JulCesarCorrea/Basic-EPS/Docs/Componentes_EPS.xlsx

Part | Manufacturer | Quantity | Price ($) | Footprint (mm²) | Description | LCSC PART | Reserva | Notas | Mass (mg) | Type
TPS54560DDAR | TI | 1 | $ 1,11 | 4x6mm | Buck | C31966 |  | Temperatura |  | Extend
RS1040-6R8MS | Ruishen | 1 | $ 0.142 | 11x10mm | Indutor | C32712978 |  | Poucos em estoque |  | Extend
B560C-13-F | DIODES | 1 | $ 0.19 | 6x7mm | Diodo | 85100 |  | Temperatura |  | Extend
TMK325B7226KMHP | Taiyo Yuden | 2 | $ 0.34 | 2x3mm | capatior 22uF | C386098 |  | 1210 X7R |  | Extend
FN18X104K250PSG | PSA | 2 | $ 0.01 | 1x1,5mm | capator 100nF | C235730 |  | 0603 - X7R |  | Extend
0603WAF2373T5E | UNI-ROYAL | 1 | $ 0.0025 | 1x1mm | RES 237kΩ ±1% 100mW 0603 | C22914 |  |  |  | Extend
0603WAF4872T5E | UNI-ROYAL | 1 | $ 0.0023 | 1x1mm | RES 48.7kΩ ±1% 100mW 0603 | C23063 |  |  |  | Extend
CGA9N3X7R1C476MT0Y0N | TDK | 3 | $ 1.13 | 4x5mm | CAP CER 47uF 16V X7R 2220 | C342293 |  |  |  | Extend
CRCW0603243KFKEA | VISHAY | 1 | $ 0.0071 | 1x1,5mm | RES 243kΩ ±1% 100mW 0603 | C4330332 |  |  |  | Extend
0603WAF1692T5E | UNI-ROYAL | 1 | $ 0.0015 | 1x1,5mm | RES 16.9kΩ ±1% 100mW 0603 | C25954 |  |  |  | Extend
CC0805KRX7R0BB472 | YAGEO | 1 | $ 0.0135 | 2x1,5mm | CAP CER 4.7nF 100V X7R 0805 | C282077 |  |  |  | Extend
CL10C470JB8NNNC | Samsung Electro-Mechanics | 1 | $ 0.0075 | 1x1,5mm | CAP CER 47pF 50V C0G 0603 | C1671 |  |  |  | Basic
FRC0402F5232TS | FOJAN | 1 | $ 0.0013 | 1x0,5mm | RES 52.3kΩ ±1% 62.5mW 0402 | C2998086 |  |  |  | Extend
RC0603FR-0710KL | YAGEO | 1 | $ 0.0027 | 1x1,5mm | RES 10kΩ ±1% 100mW 0603 | C98220 |  |  |  | Extend
