JulCesarCorrea/Basic-EPS/Hardware/PCB/EPS&PAY/sources/PCB.csv

Reference | Qty | Value | DNP | Exclude from BOM | Exclude from Board | Exclude from Simulation | Exclude from Position Files | Footprint | Datasheet
C1,C13,C38,C43,C46,C47 | 6 | 10uF |  |  |  |  | ${EXCLUDE_FROM_POS_FILES} | EPS_PAY-Footprints:C0805
C2,C9,C44,C45 | 4 | 22uF |  |  |  |  | ${EXCLUDE_FROM_POS_FILES} | EPS_PAY-Footprints:C1206
C3,C42,C48,C49,C50 | 5 | 100nF |  |  |  |  | ${EXCLUDE_FROM_POS_FILES} | EPS_PAY-Footprints:C0603
C4 | 1 | 3.3nF |  |  |  |  | ${EXCLUDE_FROM_POS_FILES} | EPS_PAY-Footprints:C0603
C5 | 1 | 100uF |  |  |  |  | ${EXCLUDE_FROM_POS_FILES} | EPS_PAY-Footprints:C1206
D1 | 1 | SS54 |  |  |  |  | ${EXCLUDE_FROM_POS_FILES} | EPS_PAY-Footprints:SMB_L4.3-W3.6-LS5.4-RD | https://cn.bing.com/search?q=datasheet： SMBJ5.0A-QH
D2 | 1 | LED_GREEN |  |  |  |  | ${EXCLUDE_FROM_POS_FILES} | EPS_PAY-Footprints:LED0603-FD
D8 | 1 | USBLC6-2P6_C2827693 |  |  |  |  | ${EXCLUDE_FROM_POS_FILES} | EPS_PAY-Footprints:SOT-666-6_L1.6-W1.2-P0.50-LS1.6-BL | https://item.szlcsc.com/161500.html
D9 | 1 | SS34 |  |  |  |  | ${EXCLUDE_FROM_POS_FILES} | Diode_SMD:D_SMA | https://www.vishay.com/docs/88751/ss32.pdf
L1 | 1 | 6.8uH |  |  |  |  | ${EXCLUDE_FROM_POS_FILES} | EPS_PAY-Footprints:IND-SMD_L5.4-W5.2
L6 | 1 | 2.2uH |  |  |  |  | ${EXCLUDE_FROM_POS_FILES} | EPS_PAY-Footprints:L1008
R1 | 1 | 52.5KΩ |  |  |  |  | ${EXCLUDE_FROM_POS_FILES} | EPS_PAY-Footprints:R0402
R2 | 1 | 200KΩ |  |  |  |  | ${EXCLUDE_FROM_POS_FILES} | EPS_PAY-Footprints:R0603
R3 | 1 | 22KΩ |  |  |  |  | ${EXCLUDE_FROM_POS_FILES} | EPS_PAY-Footprints:R0603
R15 | 1 | 10KΩ |  |  |  |  | ${EXCLUDE_FROM_POS_FILES} | EPS_PAY-Footprints:R0603
R31 | 1 | 55kΩ |  |  |  |  | ${EXCLUDE_FROM_POS_FILES} | Resistor_SMD:R_0603_1608Metric_Pad0.98x0.95mm_HandSolder
R32,R50 | 2 | 100KΩ |  |  |  |  | ${EXCLUDE_FROM_POS_FILES} | EPS_PAY-Footprints:R0603 | https://www.mouser.in/datasheet/2/447/PYu_RT_1_to_0_01_RoHS_L_11-1669912.pdf
R33 | 1 | 33kΩ |  |  |  |  | ${EXCLUDE_FROM_POS_FILES} | Resistor_SMD:R_1206_3216Metric_Pad1.30x1.75mm_HandSolder
R36,R41,R49 | 3 | 5.1KΩ |  |  | Excluída da placa |  | ${EXCLUDE_FROM_POS_FILES} | EPS_PAY-Footprints:R0603
R37 | 1 | 0.5Ω |  |  |  |  | ${EXCLUDE_FROM_POS_FILES} | EPS_PAY-Footprints:RES-SMD_L6.4-W3.2-R2512
R38 | 1 | 150Ω |  |  |  |  | ${EXCLUDE_FROM_POS_FILES} | EPS_PAY-Footprints:R0603
R39 | 1 | 100Ω |  |  |  |  | ${EXCLUDE_FROM_POS_FILES} | EPS_PAY-Footprints:R0603
R40,R42,R44,R48 | 4 | 120kΩ |  |  |  |  | ${EXCLUDE_FROM_POS_FILES} | EPS_PAY-Footprints:R0603
R43 | 1 | 60KΩ |  |  |  |  | ${EXCLUDE_FROM_POS_FILES} | EPS_PAY-Footprints:R0603
R51 | 1 | 1KΩ |  |  |  |  | ${EXCLUDE_FROM_POS_FILES} | EPS_PAY-Footprints:R0603
R52 | 1 | 82kΩ |  |  |  |  | ${EXCLUDE_FROM_POS_FILES} | EPS_PAY-Footprints:R0402
U1 | 1 | SCT2650STER |  |  |  |  | ${EXCLUDE_FROM_POS_FILES} | EPS_PAY-Footprints:ESOP-8_L4.9-W3.9-P1.27-LS6.0-BL-EP-2 | https://atta.szlcsc.com/upload/public/pdf/source/20210618/C2840771_2633849960C28F0D4B806167697E8BCA.pdf
U12 | 1 | BH-18650-A1BJ021 |  |  |  |  | ${EXCLUDE_FROM_POS_FILES} | EPS_PAY-Footprints:BAT-TH_L77.0-W39.9_BH-18650-A1BJ021 | https://atta.szlcsc.com/upload/public/pdf/source/20240112/147D77B47FAFC966051AFF7CD950677D.pdf
U16 | 1 | HX_TYPE-C_16PIN |  |  |  |  | ${EXCLUDE_FROM_POS_FILES} | EPS_PAY-Footprints:TYPE-C-SMD_HX-TYPE-C-16PIN | https://atta.szlcsc.com/upload/public/pdf/source/20220920/0EF8F885FCCEA71F60E9E85152155021.pdf
U17 | 1 | IP2326 |  |  |  |  | ${EXCLUDE_FROM_POS_FILES} | EPS_PAY-Footprints:VQFN-24_L4.0-W4.0-P0.50-BL-EP2.5 | https://list.szlcsc.com/catalog/11109.html
U18 | 1 | D2F |  |  |  |  | ${EXCLUDE_FROM_POS_FILES} | EPS_PAY-Footprints:SW-TH_D2F-L | https://item.szlcsc.com/231224.html
U19 | 1 | AO4407A_C2841482 |  |  |  |  | ${EXCLUDE_FROM_POS_FILES} | EPS_PAY-Footprints:SOP-8_L5.0-W4.0-P1.27-LS6.0-BL | https://item.szlcsc.com/7378.html
