JulCesarCorrea/Basic-EPS/Hardware/PCB/EPS&PAY/Symbols&Footprints/RASPBERRY_PI_4B_4GB/RASPBERRY_PI_4B_4GB.step

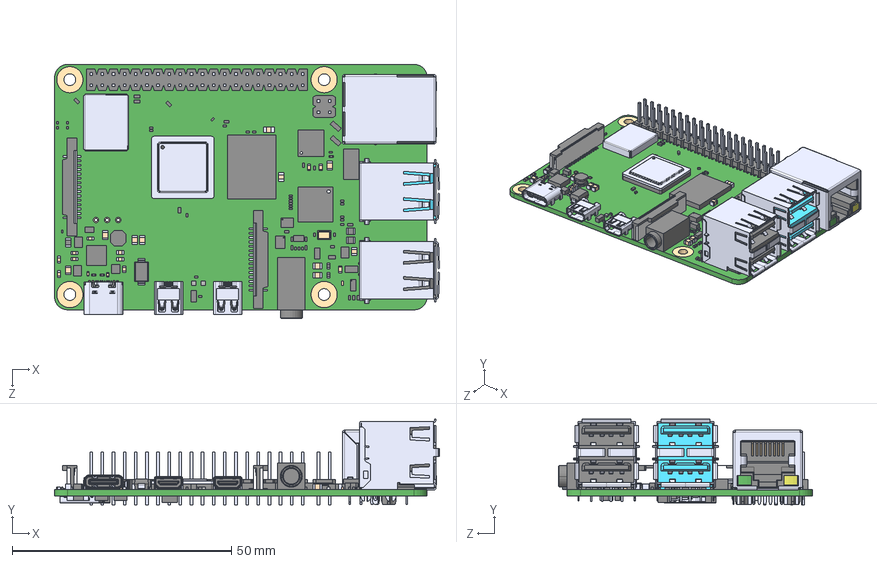
[picture p1: CAD file, 2026-10-20]
Hardware/PCB/EPS&PAY/Symbols&Footprints/RASPBERRY_PI_4B_4GB/RASPBERRY_PI_4B_4GB.step
87.8 x 19.5 x 58.0 mm
RASPBERRY PI 4B_4GB_89
RASPBERRY PI 4B_4GB_409
RASPBERRY PI 4B_4GB_79
RASPBERRY PI 4B_4GB_199
RASPBERRY PI 4B_4GB_66
RASPBERRY PI 4B_4GB_316
RASPBERRY PI 4B_4GB_146
RASPBERRY PI 4B_4GB_40
RASPBERRY PI 4B_4GB_74
RASPBERRY PI 4B_4GB_193
RASPBERRY PI 4B_4GB_363
RASPBERRY PI 4B_4GB_200
RASPBERRY PI 4B_4GB_121
RASPBERRY PI 4B_4GB_153
RASPBERRY PI 4B_4GB_304
RASPBERRY PI 4B_4GB_355
RASPBERRY PI 4B_4GB_439
RASPBERRY PI 4B_4GB_217
RASPBERRY PI 4B_4GB_46
RASPBERRY PI 4B_4GB_57
RASPBERRY PI 4B_4GB_314
RASPBERRY PI 4B_4GB_300
RASPBERRY PI 4B_4GB_247
RASPBERRY PI 4B_4GB_11
RASPBERRY PI 4B_4GB_218
RASPBERRY PI 4B_4GB_106
RASPBERRY PI 4B_4GB_288
RASPBERRY PI 4B_4GB_262
RASPBERRY PI 4B_4GB_423
RASPBERRY PI 4B_4GB_197
RASPBERRY PI 4B_4GB_402
RASPBERRY PI 4B_4GB_97
RASPBERRY PI 4B_4GB_225
RASPBERRY PI 4B_4GB_235
RASPBERRY PI 4B_4GB_133
RASPBERRY PI 4B_4GB_30
RASPBERRY PI 4B_4GB_335
RASPBERRY PI 4B_4GB_387
RASPBERRY PI 4B_4GB_422
RASPBERRY PI 4B_4GB_386
RASPBERRY PI 4B_4GB_123
RASPBERRY PI 4B_4GB_289
RASPBERRY PI 4B_4GB_414
RASPBERRY PI 4B_4GB_178
RASPBERRY PI 4B_4GB_219
RASPBERRY PI 4B_4GB_341
RASPBERRY PI 4B_4GB_211
RASPBERRY PI 4B_4GB_9
RASPBERRY PI 4B_4GB_54
RASPBERRY PI 4B_4GB_429
RASPBERRY PI 4B_4GB_165
RASPBERRY PI 4B_4GB_42
RASPBERRY PI 4B_4GB_169
RASPBERRY PI 4B_4GB_150
RASPBERRY PI 4B_4GB_408
RASPBERRY PI 4B_4GB_185
RASPBERRY PI 4B_4GB_239
RASPBERRY PI 4B_4GB_12
RASPBERRY PI 4B_4GB_117
RASPBERRY PI 4B_4GB_131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
