JulCesarCorrea/Basic-EPS/Hardware/PCB/EPS&PAY/sources/PCB.kicad_pcb

## KiCad design Hardware/PCB/EPS&PAY/sources/PCB.kicad_pcb (2026-10-22)

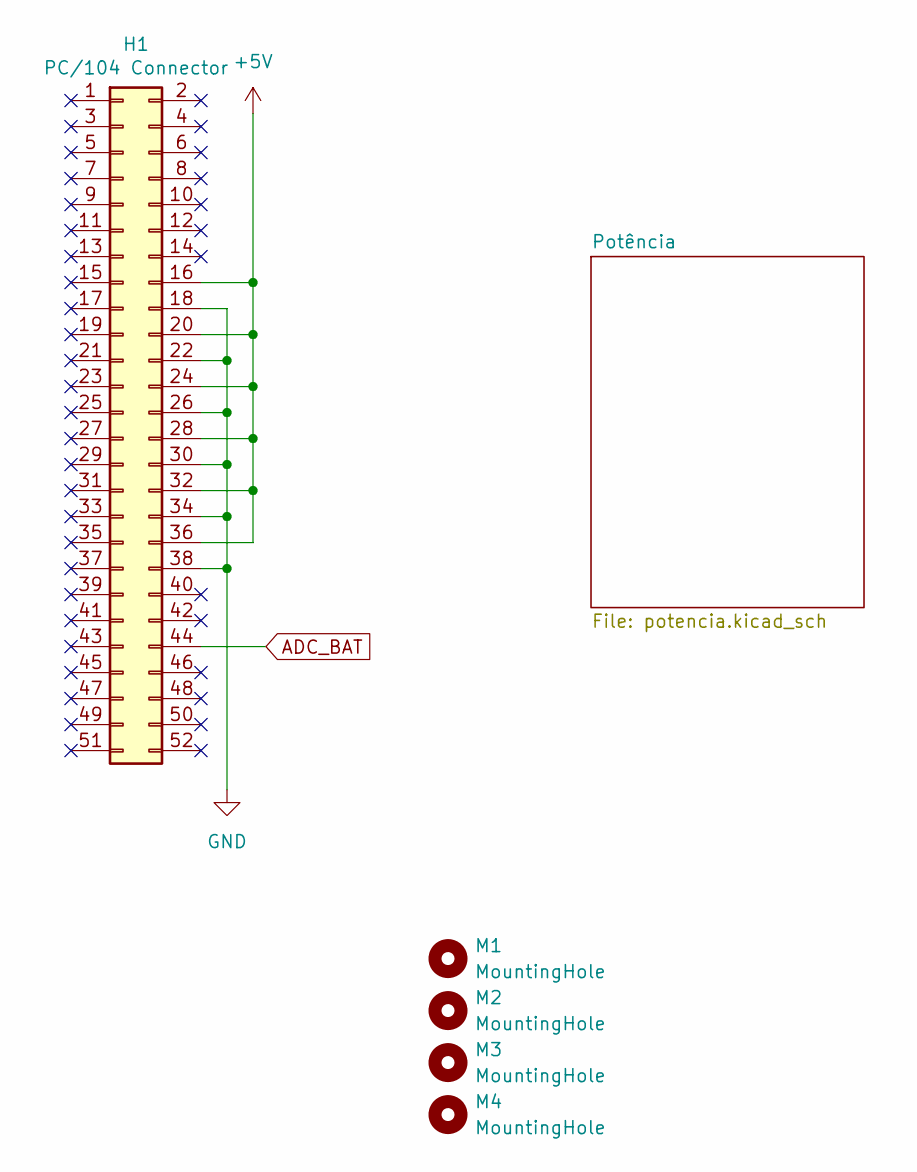
[picture p2: schematic PCB.kicad_sch]

Parts:
H1: PC/104 Connector; PinSocket_2x26_P2.54mm_Vertical
M1, M2, M3, M4: MountingHole; MountingHole_3.2mm_M3_Pad

Connections:
+5V: H1.16, H1.20, H1.24, H1.28, H1.32, H1.36; also elsewhere on the board
ADC_BAT: H1.44; also elsewhere on the board
GND: H1.18, H1.22, H1.26, H1.30, H1.34, H1.38; also elsewhere on the board

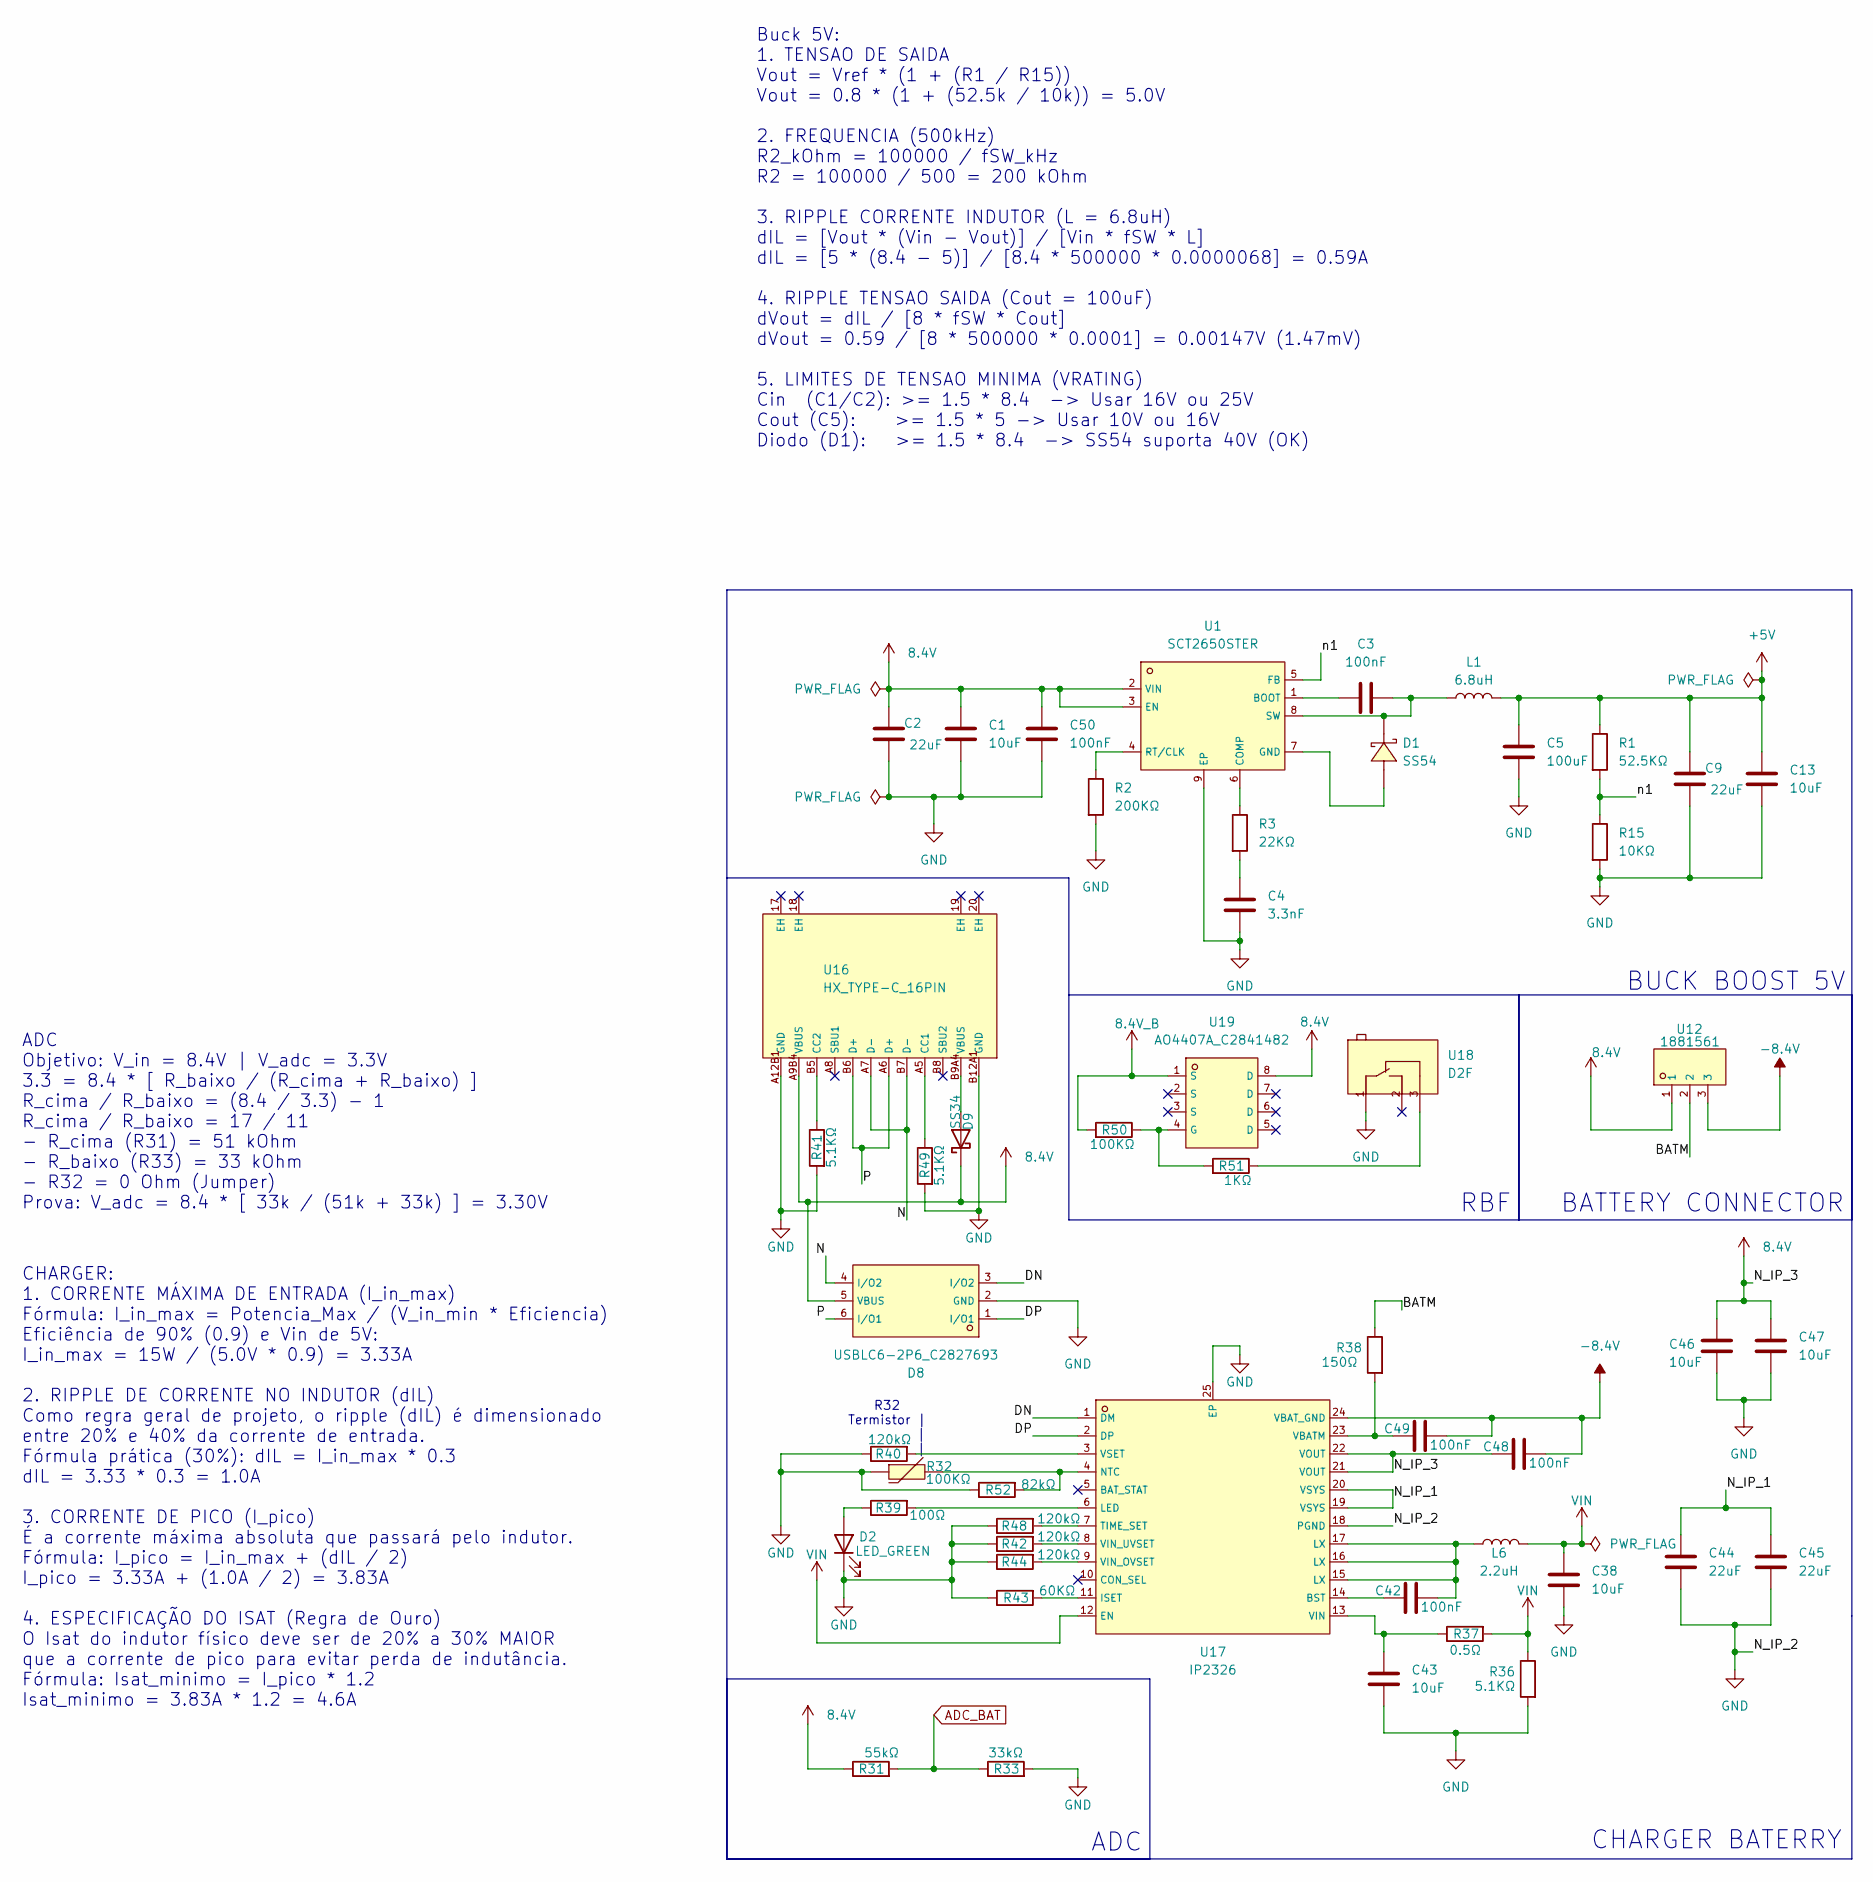
[picture p3: schematic potencia.kicad_sch]

Parts:
C1, C13, C38, C43, C46, C47: 10uF; C0805; LCSC C440198
C2, C9, C44, C45: 22uF; C1206; LCSC C3038553
C3, C42, C48, C49, C50: 100nF; C0603; LCSC C14663
C4: 3.3nF; C0603; LCSC C1613
C5: 100uF; C1206; LCSC C3038553
D1: SS54; SMB_L4.3-W3.6-LS5.4-RD; LCSC C5200096
D2: LED_GREEN; LED0603-FD; LCSC C19273151
D8: USBLC6-2P6_C2827693; SOT-666-6_L1.6-W1.2-P0.50-LS1.6-BL; LCSC C2827693
D9: SS34; D_SMA
L1: 6.8uH; IND-SMD_L5.4-W5.2; LCSC C718382
L6: 2.2uH; L1008; LCSC C42455362
R1: 52.5KΩ; R0402; LCSC C2998086
R2: 200KΩ; R0603; LCSC C2907009
R3: 22KΩ; R0603; LCSC C2907015
R15: 10KΩ; R0603; LCSC C98220
R31: 55kΩ; R_0603_1608Metric_Pad0.98x0.95mm_HandSolder; LCSC C2933461
R32: 100KΩ; R0603; LCSC C71280
R33: 33kΩ; R_1206_3216Metric_Pad1.30x1.75mm_HandSolder; LCSC C2933415
R36, R41, R49: 5.1KΩ; R0603; LCSC C2907044
R37: 0.5Ω; RES-SMD_L6.4-W3.2-R2512; LCSC C2904268
R38: 150Ω; R0603; LCSC C2933324
R39: 100Ω; R0603; LCSC C2906981
R40, R42, R44, R48: 120kΩ; R0603; LCSC C25808
R43: 60KΩ; R0603; LCSC C2907044
R50: 100KΩ; R0603; LCSC C14675
R51: 1KΩ; R0603; LCSC C22548
R52: 82kΩ; R0402; LCSC C2909388
U1: SCT2650STER; ESOP-8_L4.9-W3.9-P1.27-LS6.0-BL-EP-2; LCSC C2840771
U12: 1881561; CONN-TH_3P-P2.50_C3585554; LCSC C3585554
U16: HX_TYPE-C_16PIN; TYPE-C-SMD_HX-TYPE-C-16PIN; LCSC C5178539
U17: IP2326; VQFN-24_L4.0-W4.0-P0.50-BL-EP2.5; LCSC C2832094
U18: D2F; SW-TH_D2F-L; LCSC C397279
U19: AO4407A_C2841482; SOP-8_L5.0-W4.0-P1.27-LS6.0-BL; LCSC C2841482

Connections:
8.4V: C1.1, C2.1, C46.1, C47.1, C48.2, C50.2, D8.5 (VBUS), D9.1 (K), R31.1, U1.2 (VIN), U1.3 (EN), U12.1, U16.A9B4 (VBUS), U17.21 (VOUT), U17.22 (VOUT), U19.8 (D)
8.4V_B: R50.2, U19.1 (S)
+5V: C5.1, C9.1, C13.1, L1.2, R1.1; also elsewhere on the board
-8.4V: C48.1, C49.1, U12.3, U17.24 (VBAT_GND)
/Potência/BATM: R38.1, U12.2
/Potência/DN: D8.3 (I/O2), U17.1 (DM)
/Potência/DP: D8.1 (I/O1), U17.2 (DP)
/Potência/N: D8.4 (I/O2), U16.A7 (D-), U16.B7 (D-)
/Potência/N_IP_1: C44.1, C45.1, U17.19 (VSYS), U17.20 (VSYS)
/Potência/P: D8.6 (I/O1), U16.A6 (D+), U16.B6 (D+)
/Potência/n1: R1.2, R15.1, U1.5 (FB)
ADC_BAT: R31.2, R33.1; also elsewhere on the board
GND: C1.2, C2.2, C4.2, C5.2, C9.2, C13.2, C38.2, C43.2, C44.2, C45.2, C46.2, C47.2, C50.1, D2.1 (K), D8.2 (GND), R2.2, R15.2, R32.1, R33.2, R36.2, R40.1, R41.2, R42.1, R43.1, R44.1, R48.1, R49.2, R52.1, U1.9 (EP), U16.A12B1 (GND), U16.B12A1 (GND), U17.18 (PGND), U17.25 (EP), U18.1 (COM); also elsewhere on the board
unnamed: C4.1, R3.2
unnamed: C42.1, L6.1, U17.15 (LX), U17.16 (LX), U17.17 (LX)
unnamed: D2.2 (A), R39.1
unnamed: D9.2 (A), U16.B9A4 (VBUS)
unnamed: C3.1, U1.1 (BOOT)
unnamed: R3.1, U1.6 (COMP)
unnamed: D1.2, U1.7 (GND)
unnamed: R2.1, U1.4 (RT/CLK)
unnamed: C3.2, D1.1, L1.1, U1.8 (SW)
unnamed: R49.1, U16.A5 (CC1)
unnamed: R41.1, U16.B5 (CC2)
unnamed: C42.2, U17.14 (BST)
unnamed: R43.2, U17.11 (ISET)
unnamed: R39.2, U17.6 (LED)
unnamed: R32.2, R52.2, U17.4 (NTC)
unnamed: R48.2, U17.7 (TIME_SET)
unnamed: C49.2, R38.2, U17.23 (VBATM)
unnamed: C43.1, R37.1, U17.13 (VIN)
unnamed: R44.2, U17.9 (VIN_OVSET)
unnamed: R42.2, U17.8 (VIN_UVSET)
unnamed: R40.2, U17.3 (VSET)
unnamed: R51.1, U18.3 (NC)
unnamed: R50.1, R51.2, U19.4 (G)
VIN: C38.1, L6.2, R36.1, R37.2, U17.12 (EN)

Notes on the sheet:
CHARGER BATERRY
Buck 5V: 1. TENSAO DE SAIDA Vout = Vref * (1 + (R1 / R15)) Vout = 0.8 * (1 + (52.5k / 10k)) = 5.0V 2. FREQUENCIA (500kHz) R2_kOhm = 100000 / fSW_kHz R2 = 100000 / 500 = 200 kOhm 3. RIPPLE CORRENTE INDUTOR (L = 6.8uH) dIL = [Vout * (Vin - Vout)] / [Vin * fSW * L] dIL = [5 * (8.4 - 5)] / [8.4 * 50000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
BUCK BOOST 5V
ADC Objetivo: V_in = 8.4V | V_adc = 3.3V 3.3 = 8.4 * [ R_baixo / (R_cima + R_baixo) ] R_cima / R_baixo = (8.4 / 3.3) - 1 R_cima / R_baixo = 17 / 11 - R_cima (R31) = 51 kOhm - R_baixo (R33) = 33 kOhm - R32 = 0 Ohm (Jumper) Prova: V_adc = 8.4 * [ 33k / (51k + 33k) ] = 3.30V
CHARGER: 1. CORRENTE MÁXIMA DE ENTRADA (I_in_max) Fórmula: I_in_max = Potencia_Max / (V_in_min * Eficiencia) Eficiência de 90% (0.9) e Vin de 5V: I_in_max = 15W / (5.0V * 0.9) = 3.33A 2. RIPPLE DE CORRENTE NO INDUTOR (dIL) Como regra geral de projeto, o ripple (dIL) é dimensionado entre 20% e 40% d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
R32 Termistor | | |
BATTERY CONNECTOR
ADC
RBF

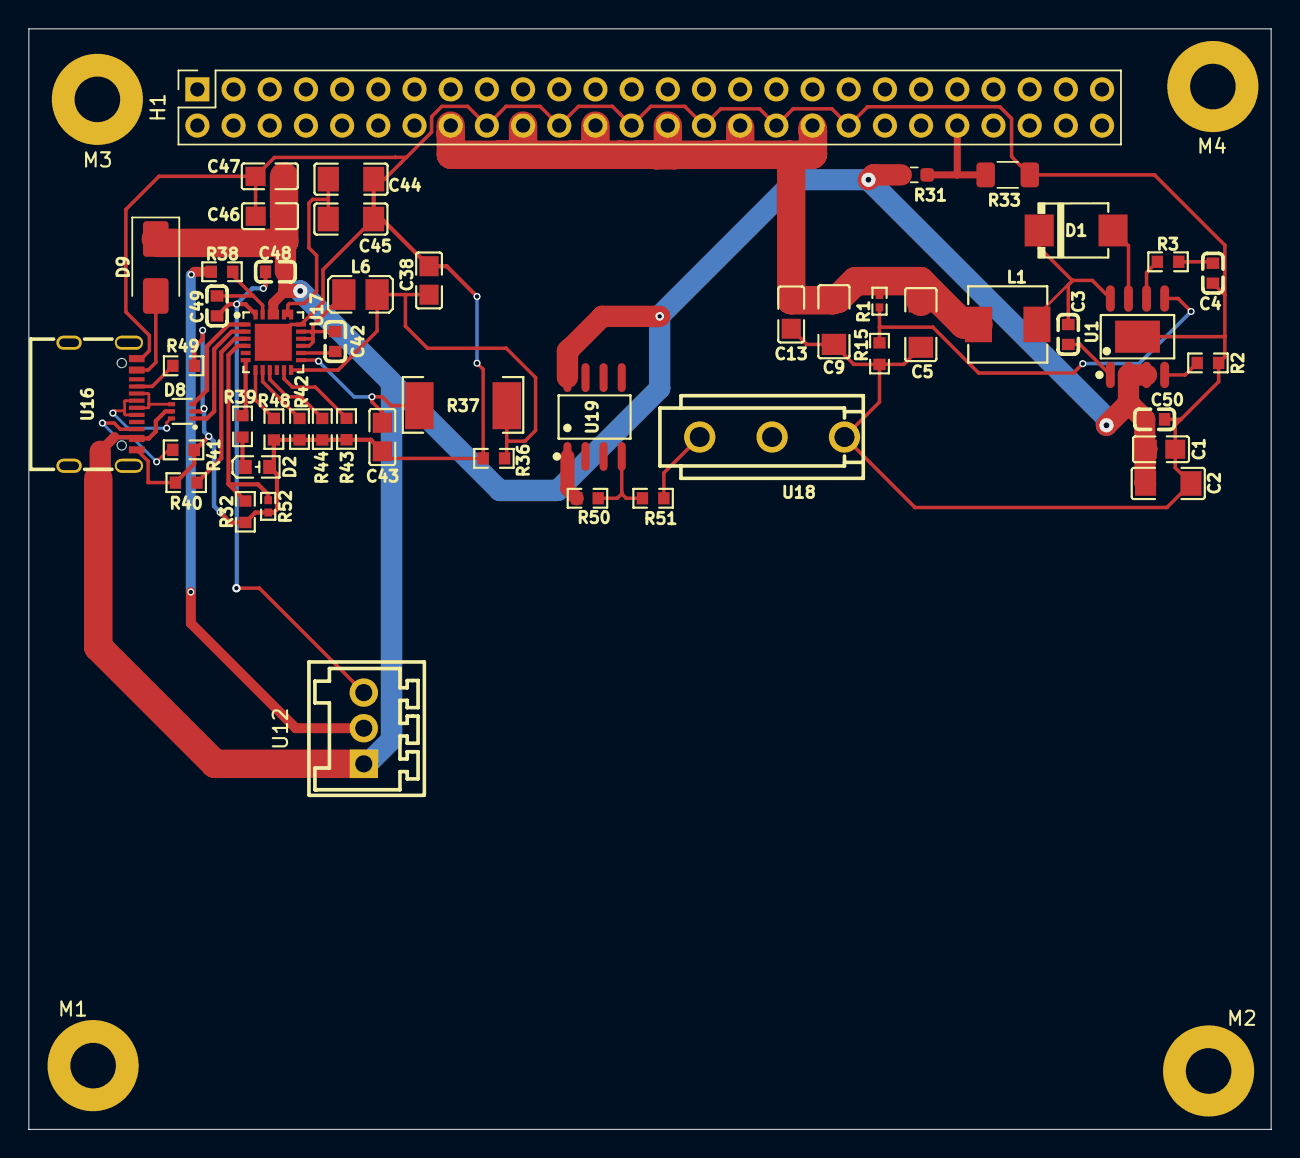
[picture p4: board Hardware/PCB/EPS&PAY/sources/PCB.kicad_pcb from above]

Board: 2 copper layers, 87.2 x 77.2 mm, 55 parts (0 on the bottom side), 37 nets.
