JulCesarCorrea/Basic-EPS/Hardware/PCB/EPS&PAY/sources/_restore_backup_2026-10-15T00-06-46-763/PCB.kicad_pcb

## KiCad design Hardware/PCB/EPS&PAY/sources/_restore_backup_2026-10-15T00-06-46-763/PCB.kicad_pcb (2026-10-20)

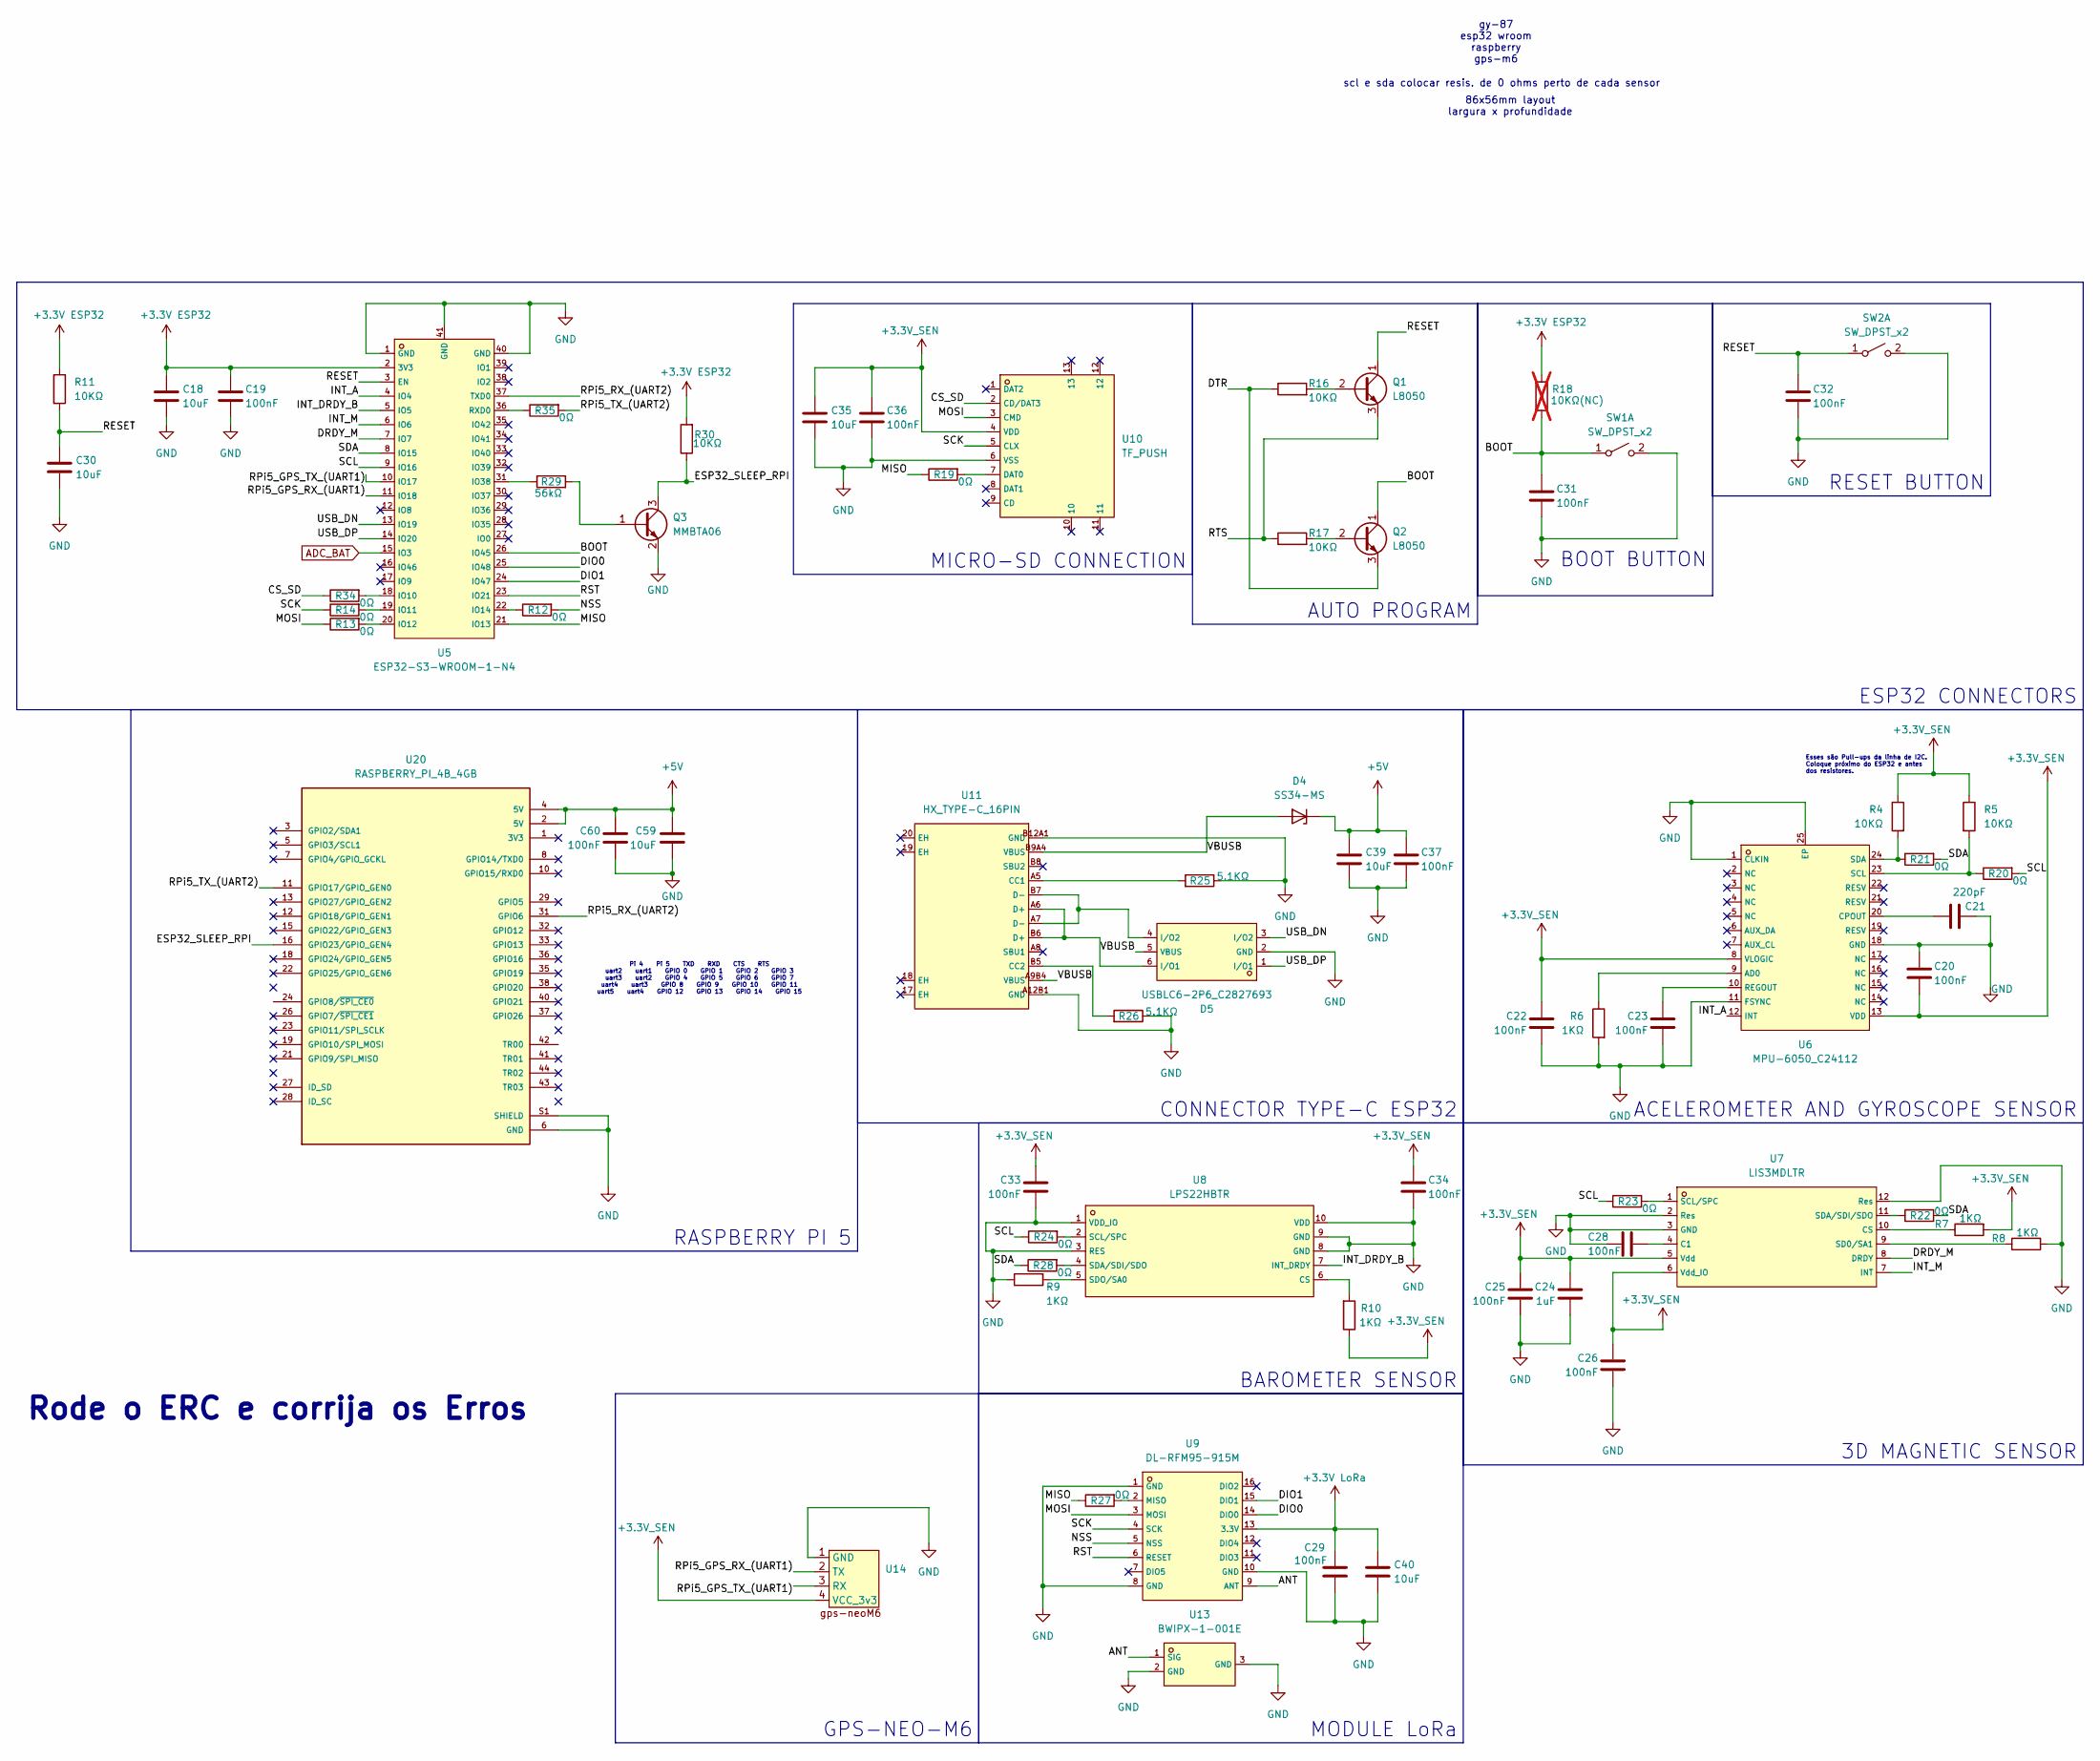
[picture p5: schematic carga_util.kicad_sch]

Parts:
C18, C30, C35, C39, C40, C59: 10uF; C0805; LCSC C440198
C19, C20, C22, C23, C25, C26, C28, C29, C31, C32, C33, C34, C36, C37, C60: 100nF; C0603; LCSC C14663
C21: 220pF; C0603; LCSC C1603
C24: 1uF; C0805; LCSC C541528
D4: SS34-MS; DO-214AC_L4.3-W2.7-LS5.0-RD; LCSC C2836396
D5: USBLC6-2P6_C2827693; SOT-666-6_L1.6-W1.2-P0.50-LS1.6-BL; LCSC C2827693
Q1, Q2: L8050; SOT-23-3_L2.9-W1.3-P1.90-LS2.4-BR; LCSC C49581
Q3: MMBTA06; SOT-23-3_L2.9-W1.6-P1.90-LS2.8-BR
R4, R5, R11, R16, R17, R30: 10KΩ; R0603; LCSC C98220
R6, R7, R8, R9, R10: 1KΩ; R0603; LCSC C22548
R12, R13, R14, R19, R20, R21, R22, R23, R24, R27, R28, R34, R35: 0Ω; R0603; LCSC C95177
R18: 10KΩ(NC); R0603; LCSC C98220; not fitted
R25, R26: 5.1KΩ; R0603; LCSC C2907044
R29: 56kΩ; R0603
SW1, SW2: SW_DPST_x2; SW-SMD_L3.9-W3.0-P4.45; LCSC C720477
U5: ESP32-S3-WROOM-1-N4; WIFIM-SMD_ESP32-S3-WROOM-1-N8; LCSC C2913197
U6: MPU-6050_C24112; QFN-24_L4.0-W4.0-P0.50-BL-EP2.7; LCSC C24112
U7: LIS3MDLTR; LGA-12_L2.0-W2.0-P0.50-BL; LCSC C478483
U8: LPS22HBTR; HLGA-10L_LPS22HBTR; LCSC C94049
U9: DL-RFM95-915M; LCC-16_L16.0-W16.0-P2.00-TL; LCSC C2844473
U10: TF_PUSH; TF-SMD_TF-PUSH; LCSC C393941
U11: HX_TYPE-C_16PIN; TYPE-C-SMD_HX-TYPE-C-16PIN; LCSC C5178539
U13: BWIPX-1-001E; IPEX-SMD_BWIPX-1-001E; LCSC C496552
U14: GPS_NEO-M6
U20: RASPBERRY_PI_4B_4GB; MODULE_RASPBERRY_PI_4B_4GB; PARTREV 4

Connections:
+3.3V ESP32: C18.1, C19.2, R11.1, R18.2, R30.2, U5.2 (3V3); also elsewhere on the board
+3.3V LoRa: C29.2, C40.1, U9.13 (3.3V); also elsewhere on the board
+3.3V_SEN: C20.1, C22.2, C24.2, C25.2, C26.2, C33.2, C34.2, C35.1, C36.2, R4.1, R5.1, R7.2, R10.1, U6.8 (VLOGIC), U6.13 (VDD), U7.5 (Vdd), U7.6 (Vdd_IO), U10.4 (VDD), U14.4 (VCC_3v3); also elsewhere on the board
+5V: C37.2, C39.1, C59.1, C60.2, D4.1 (K), U20.2 (5V), U20.4 (5V); also elsewhere on the board
/Carga Útil/ANT: U9.9 (ANT), U13.1 (SIG)
/Carga Útil/BOOT: C31.2, Q2.1 (C), R18.1, SW1.1 (A), U5.26 (IO45)
/Carga Útil/CS_SD: R34.1, U10.2 (CD/DAT3)
/Carga Útil/DIO0: U5.25 (IO48), U9.14 (DIO0)
/Carga Útil/DIO1: U5.24 (IO47), U9.15 (DIO1)
/Carga Útil/DRDY_M: U5.7 (IO7), U7.8 (DRDY)
/Carga Útil/DTR: Q2.3 (E), R16.1
/Carga Útil/ESP32_SLEEP_RPI: Q3.3 (C), R30.1, U20.16 (GPIO23/GPIO_GEN4)
/Carga Útil/INT_A: U5.4 (IO4), U6.12 (INT)
/Carga Útil/INT_DRDY_B: U5.5 (IO5), U8.7 (INT_DRDY)
/Carga Útil/INT_M: U5.6 (IO6), U7.7 (INT)
/Carga Útil/MISO: R19.1, R27.1, U5.21 (IO13)
/Carga Útil/MOSI: R13.1, U9.3 (MOSI), U10.3 (CMD)
/Carga Útil/NSS: R12.2, U9.5 (NSS)
/Carga Útil/RESET: C30.1, C32.2, Q1.1 (C), R11.2, SW2.1 (A), U5.3 (EN)
/Carga Útil/RPi5_GPS_RX_(UART1): U5.11 (IO18), U14.2 (TX)
/Carga Útil/RPi5_GPS_TX_(UART1): U5.10 (IO17), U14.3 (RX)
/Carga Útil/RPi5_RX_(UART2): U5.37 (TXD0), U20.31 (GPIO6)
/Carga Útil/RPi5_TX_(UART2): R35.2, U20.11 (GPIO17/GPIO_GEN0)
/Carga Útil/RST: U5.23 (IO21), U9.6 (RESET)
/Carga Útil/RTS: Q1.3 (E), R17.1
/Carga Útil/SCK: R14.1, U9.4 (SCK), U10.5 (CLX)
/Carga Útil/SCL: R20.2, R23.1, R24.1, U5.9 (IO16)
/Carga Útil/SDA: R21.2, R22.2, R28.1, U5.8 (IO15)
/Carga Útil/USB_DN: D5.3 (I/O2), U5.13 (IO19)
/Carga Útil/USB_DP: D5.1 (I/O1), U5.14 (IO20)
/Carga Útil/VBUSB: D4.2 (A), D5.5 (VBUS), U11.A9B4 (VBUS), U11.B9A4 (VBUS)
ADC_BAT: U5.15 (IO3); also elsewhere on the board
GND: C18.2, C19.1, C20.2, C21.1, C22.1, C23.1, C24.1, C25.1, C26.1, C28.1, C29.1, C30.2, C31.1, C32.1, C33.1, C34.1, C35.2, C36.1, C37.1, C39.2, C40.2, C59.2, C60.1, D5.2 (GND), Q3.2 (E), R6.2, R8.2, R9.1, R25.1, R26.1, SW1.2 (B), SW2.2 (B), U5.1 (GND), U5.40 (GND), U5.41 (GND), U6.1 (CLKIN), U6.11 (FSYNC), U6.18 (GND), U6.25 (EP), U7.2 (Res), U7.3 (GND), U7.12 (Res), U8.1 (VDD_IO), U8.3 (RES), U8.8 (GND), U8.9 (GND), U8.10 (VDD), U9.1 (GND), U9.8 (GND), U9.10 (GND), U10.6 (VSS), U11.A12B1 (GND), U11.B12A1 (GND), U13.2 (GND), U13.3 (GND), U14.1 (GND), U20.6 (GND), U20.9 (GND), U20.14 (GND), U20.20 (GND), U20.25 (GND), U20.30 (GND), U20.34 (GND), U20.39 (GND), U20.S1 (SHIELD), U20.S2 (SHIELD), U20.S3 (SHIELD), U20.S4 (SHIELD); also elsewhere on the board
unnamed: D5.6 (I/O1), U11.A6 (D+), U11.B6 (D+)
unnamed: D5.4 (I/O2), U11.A7 (D-), U11.B7 (D-)
unnamed: Q1.2 (B), R16.2
unnamed: Q2.2 (B), R17.2
unnamed: Q3.1 (B), R29.2
unnamed: R34.2, U5.18 (IO10)
unnamed: R14.2, U5.19 (IO11)
unnamed: R13.2, U5.20 (IO12)
unnamed: R12.1, U5.22 (IO14)
unnamed: R29.1, U5.31 (IO38)
unnamed: R35.1, U5.36 (RXD0)
unnamed: R6.1, U6.9 (AD0)
unnamed: C21.2, U6.20 (CPOUT)
unnamed: C23.2, U6.10 (REGOUT)
unnamed: R5.2, R20.1, U6.23 (SCL)
unnamed: R4.2, R21.1, U6.24 (SDA)
unnamed: C28.2, U7.4 (C1)
unnamed: R7.1, U7.10 (CS)
unnamed: R23.2, U7.1 (SCL/SPC)
unnamed: R8.1, U7.9 (SD0/SA1)
unnamed: R22.1, U7.11 (SDA/SDI/SDO)
unnamed: R10.2, U8.6 (CS)
unnamed: R24.2, U8.2 (SCL/SPC)
unnamed: R28.2, U8.4 (SDA/SDI/SDO)
unnamed: R9.2, U8.5 (SDO/SA0)
unnamed: R27.2, U9.2 (MISO)
unnamed: R19.2, U10.7 (DAT0)
unnamed: R25.2, U11.A5 (CC1)
unnamed: R26.2, U11.B5 (CC2)

Notes on the sheet:
scl e sda colocar resis. de 0 ohms perto de cada sensor
Pi 4 Pi 5 TXD RXD CTS RTS uart2 uart1 GPIO 0 GPIO 1 GPIO 2 GPIO 3 uart3 uart2 GPIO 4 GPIO 5 GPIO 6 GPIO 7 uart4 uart3 GPIO 8 GPIO 9 GPIO 10 GPIO 11 uart5 uart4 GPIO 12 GPIO 13 GPIO 14 GPIO 15
86x56mm layout largura x profundidade
Esses são Pull-ups da linha de I2C. Coloque próximo do ESP32 e antes dos resistores.
gy-87 esp32 wroom raspberry gps-m6
Rode o ERC e corrija os Erros
CONNECTOR TYPE-C ESP32
RASPBERRY PI 5
ACELEROMETER AND GYROSCOPE SENSOR
GPS-NEO-M6
BOOT BUTTON
MICRO-SD CONNECTION
AUTO PROGRAM
BAROMETER SENSOR
RESET BUTTON
ESP32 CONNECTORS
3D MAGNETIC SENSOR
MODULE LoRa

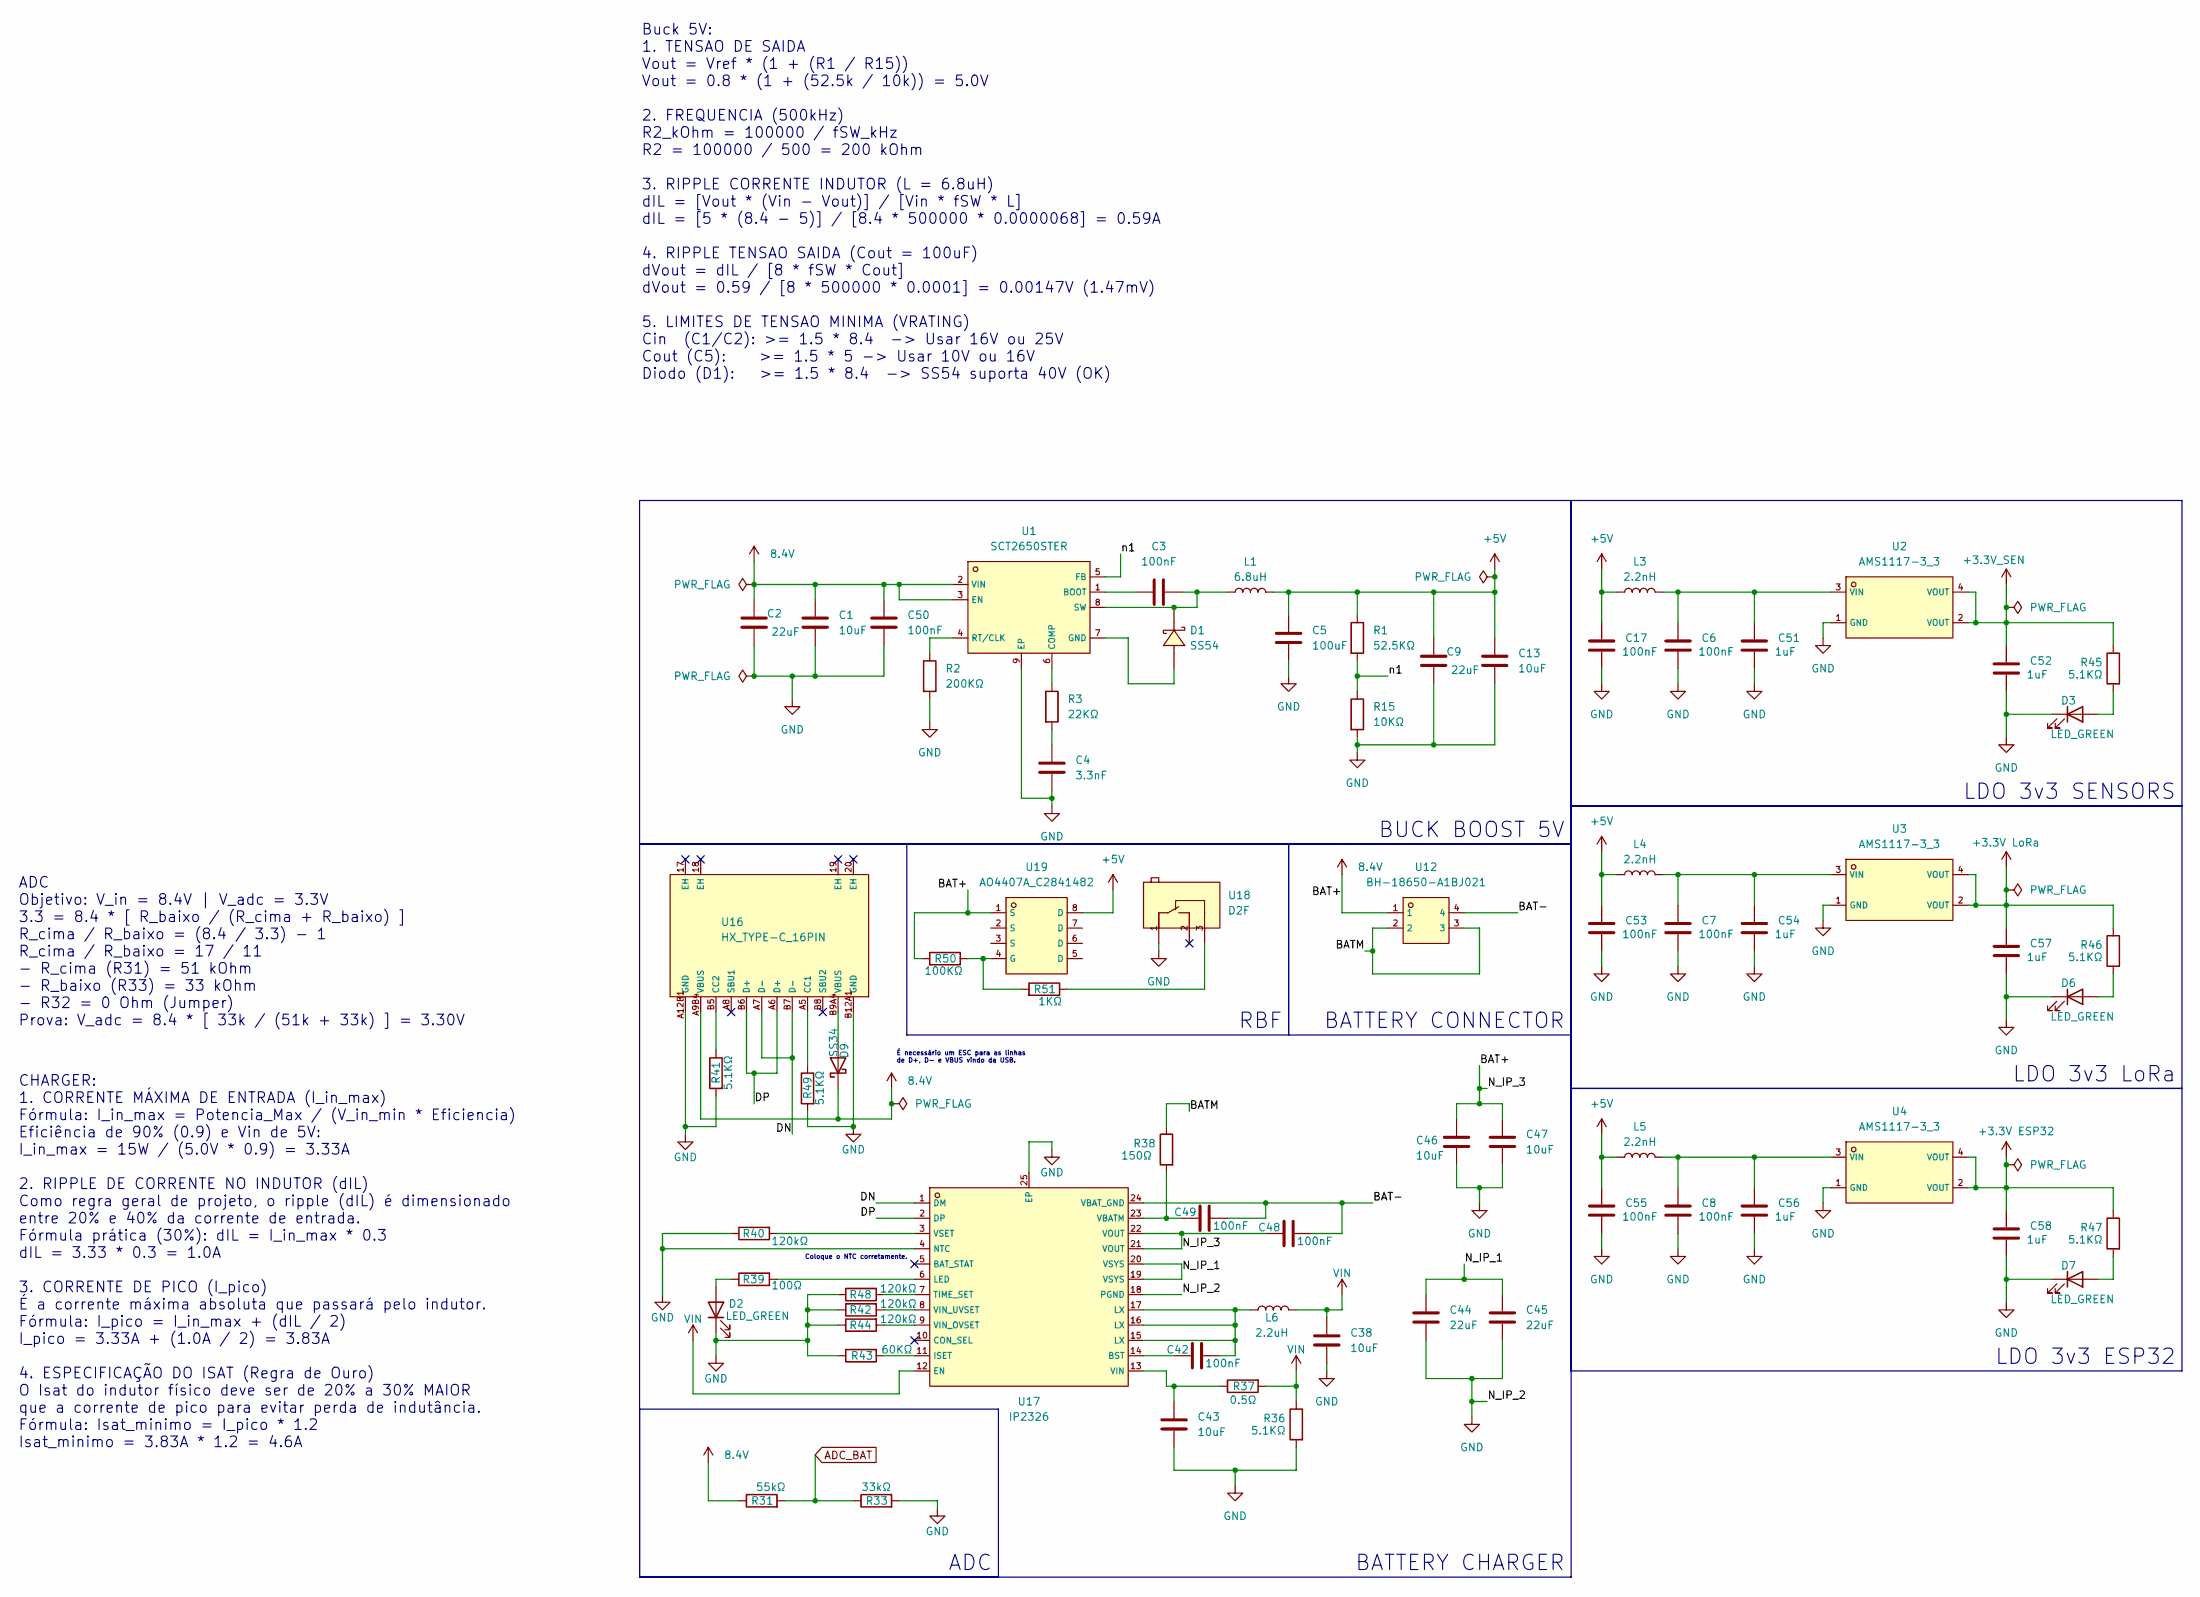
[picture p6: schematic potencia.kicad_sch]

Parts:
C1, C13, C38, C43, C46, C47: 10uF; C0805; LCSC C440198
C2, C9, C44, C45: 22uF; C1206; LCSC C3038553
C3, C6, C7, C8, C17, C42, C48, C49, C50, C53, C55: 100nF; C0603; LCSC C14663
C4: 3.3nF; C0603; LCSC C1613
C5: 100uF; C1206; LCSC C3038553
C51, C52, C54, C56, C57, C58: 1uF; C0603; LCSC C5199872
D1: SS54; SMB_L4.3-W3.6-LS5.4-RD; LCSC C5200096
D2, D3, D6, D7: LED_GREEN; LED0603-FD; LCSC C19273151
D9: SS34; D_SMA
L1: 6.8uH; IND-SMD_L5.4-W5.2; LCSC C718382
L3, L4, L5: 2.2nH; L1008; LCSC C2041833
L6: 2.2uH; L1008; LCSC C42455362
R1: 52.5KΩ; R0402; LCSC C2998086
R2: 200KΩ; R0603; LCSC C2907009
R3: 22KΩ; R0603; LCSC C2907015
R15: 10KΩ; R0603; LCSC C98220
R31: 55kΩ; R_0603_1608Metric_Pad0.98x0.95mm_HandSolder; LCSC C2933461
R33: 33kΩ; R_1206_3216Metric_Pad1.30x1.75mm_HandSolder; LCSC C2933415
R36, R41, R45, R46, R47, R49: 5.1KΩ; R0603; LCSC C2907044
R37: 0.5Ω; RES-SMD_L6.4-W3.2-R2512; LCSC C2904268
R38: 150Ω; R0603; LCSC C2933324
R39: 100Ω; R0603; LCSC C2906981
R40, R42, R44, R48: 120kΩ; R0603; LCSC C25808
R43: 60KΩ; R0603; LCSC C2907044
R50: 100KΩ; R0603; LCSC C14675
R51: 1KΩ; R0603; LCSC C22548
U1: SCT2650STER; ESOP-8_L4.9-W3.9-P1.27-LS6.0-BL-EP-2; LCSC C2840771
U2, U3, U4: AMS1117-3_3; SOT-223-3_L6.5-W3.4-P2.30-LS7.0-BR; LCSC C6186
U12: BH-18650-A1BJ021; BAT-TH_L77.0-W39.9_BH-18650-A1BJ021; LCSC C20606804
U16: HX_TYPE-C_16PIN; TYPE-C-SMD_HX-TYPE-C-16PIN; LCSC C5178539
U17: IP2326; VQFN-24_L4.0-W4.0-P0.50-BL-EP2.5; LCSC C2832094
U18: D2F; SW-TH_D2F-L; LCSC C397279
U19: AO4407A_C2841482; SOP-8_L5.0-W4.0-P1.27-LS6.0-BL; LCSC C2841482

Connections:
8.4V: C1.1, C2.1, C46.1, C47.1, C48.2, C50.2, D9.1 (K), R31.1, R50.2, U1.2 (VIN), U1.3 (EN), U12.1, U16.A9B4 (VBUS), U17.21 (VOUT), U17.22 (VOUT), U19.1 (S)
+3.3V ESP32: C58.2, R47.1, U4.2 (VOUT), U4.4 (VOUT); also elsewhere on the board
+3.3V LoRa: C57.2, R46.1, U3.2 (VOUT), U3.4 (VOUT); also elsewhere on the board
+3.3V_SEN: C52.2, R45.1, U2.2 (VOUT), U2.4 (VOUT); also elsewhere on the board
+5V: C5.1, C9.1, C13.1, C17.2, C53.2, C55.2, L1.2, L3.1, L4.1, L5.1, R1.1, U19.8 (D); also elsewhere on the board
/Potência/BAT-: C48.1, C49.1, U12.4, U17.24 (VBAT_GND)
/Potência/BATM: R38.1, U12.2, U12.3
/Potência/DN: U16.A7 (D-), U16.B7 (D-), U17.1 (DM)
/Potência/DP: U16.A6 (D+), U16.B6 (D+), U17.2 (DP)
/Potência/N_IP_1: C44.1, C45.1, U17.19 (VSYS), U17.20 (VSYS)
/Potência/n1: R1.2, R15.1, U1.5 (FB)
ADC_BAT: R31.2, R33.1; also elsewhere on the board
GND: C1.2, C2.2, C4.2, C5.2, C6.1, C7.1, C8.1, C9.2, C13.2, C17.1, C38.2, C43.2, C44.2, C45.2, C46.2, C47.2, C50.1, C51.1, C52.1, C53.1, C54.1, C55.1, C56.1, C57.1, C58.1, D2.1 (K), D3.1 (K), D6.1 (K), D7.1 (K), R2.2, R15.2, R33.2, R36.2, R40.1, R41.2, R42.1, R43.1, R44.1, R48.1, R49.2, U1.9 (EP), U2.1 (GND), U3.1 (GND), U4.1 (GND), U16.A12B1 (GND), U16.B12A1 (GND), U17.4 (NTC), U17.18 (PGND), U17.25 (EP), U18.1 (COM); also elsewhere on the board
unnamed: C4.1, R3.2
unnamed: C42.1, L6.1, U17.15 (LX), U17.16 (LX), U17.17 (LX)
unnamed: D2.2 (A), R39.1
unnamed: D3.2 (A), R45.2
unnamed: D6.2 (A), R46.2
unnamed: D7.2 (A), R47.2
unnamed: D9.2 (A), U16.B9A4 (VBUS)
unnamed: C3.1, U1.1 (BOOT)
unnamed: R3.1, U1.6 (COMP)
unnamed: D1.2, U1.7 (GND)
unnamed: R2.1, U1.4 (RT/CLK)
unnamed: C3.2, D1.1, L1.1, U1.8 (SW)
unnamed: C6.2, C51.2, L3.2, U2.3 (VIN)
unnamed: C7.2, C54.2, L4.2, U3.3 (VIN)
unnamed: C8.2, C56.2, L5.2, U4.3 (VIN)
unnamed: R49.1, U16.A5 (CC1)
unnamed: R41.1, U16.B5 (CC2)
unnamed: C42.2, U17.14 (BST)
unnamed: R43.2, U17.11 (ISET)
unnamed: R39.2, U17.6 (LED)
unnamed: R48.2, U17.7 (TIME_SET)
unnamed: C49.2, R38.2, U17.23 (VBATM)
unnamed: C43.1, R37.1, U17.13 (VIN)
unnamed: R44.2, U17.9 (VIN_OVSET)
unnamed: R42.2, U17.8 (VIN_UVSET)
unnamed: R40.2, U17.3 (VSET)
unnamed: R51.1, U18.3 (NC)
unnamed: R50.1, R51.2, U19.4 (G)
VIN: C38.1, L6.2, R36.1, R37.2, U17.12 (EN)

Notes on the sheet:
Coloque o NTC corretamente.
Buck 5V: 1. TENSAO DE SAIDA Vout = Vref * (1 + (R1 / R15)) Vout = 0.8 * (1 + (52.5k / 10k)) = 5.0V 2. FREQUENCIA (500kHz) R2_kOhm = 100000 / fSW_kHz R2 = 100000 / 500 = 200 kOhm 3. RIPPLE CORRENTE INDUTOR (L = 6.8uH) dIL = [Vout * (Vin - Vout)] / [Vin * fSW * L] dIL = [5 * (8.4 - 5)] / [8.4 * 50000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
ADC Objetivo: V_in = 8.4V | V_adc = 3.3V 3.3 = 8.4 * [ R_baixo / (R_cima + R_baixo) ] R_cima / R_baixo = (8.4 / 3.3) - 1 R_cima / R_baixo = 17 / 11 - R_cima (R31) = 51 kOhm - R_baixo (R33) = 33 kOhm - R32 = 0 Ohm (Jumper) Prova: V_adc = 8.4 * [ 33k / (51k + 33k) ] = 3.30V
CHARGER: 1. CORRENTE MÁXIMA DE ENTRADA (I_in_max) Fórmula: I_in_max = Potencia_Max / (V_in_min * Eficiencia) Eficiência de 90% (0.9) e Vin de 5V: I_in_max = 15W / (5.0V * 0.9) = 3.33A 2. RIPPLE DE CORRENTE NO INDUTOR (dIL) Como regra geral de projeto, o ripple (dIL) é dimensionado entre 20% e 40% d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
É necessário um ESC para as linhas de D+, D- e VBUS vindo da USB.
BATTERY CONNECTOR
LDO 3v3 SENSORS
ADC
LDO 3v3 LoRa
LDO 3v3 ESP32
BATTERY CHARGER
BUCK BOOST 5V
RBF

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
