JulCesarCorrea/Basic-EPS/Hardware/PCB/EPS&PAY/sources/_restore_backup_2026-10-15T00-06-46-763/PCB.kicad_pcb

## KiCad design Hardware/PCB/EPS&PAY/sources/_restore_backup_2026-10-15T00-06-46-763/PCB.kicad_pcb (continued)

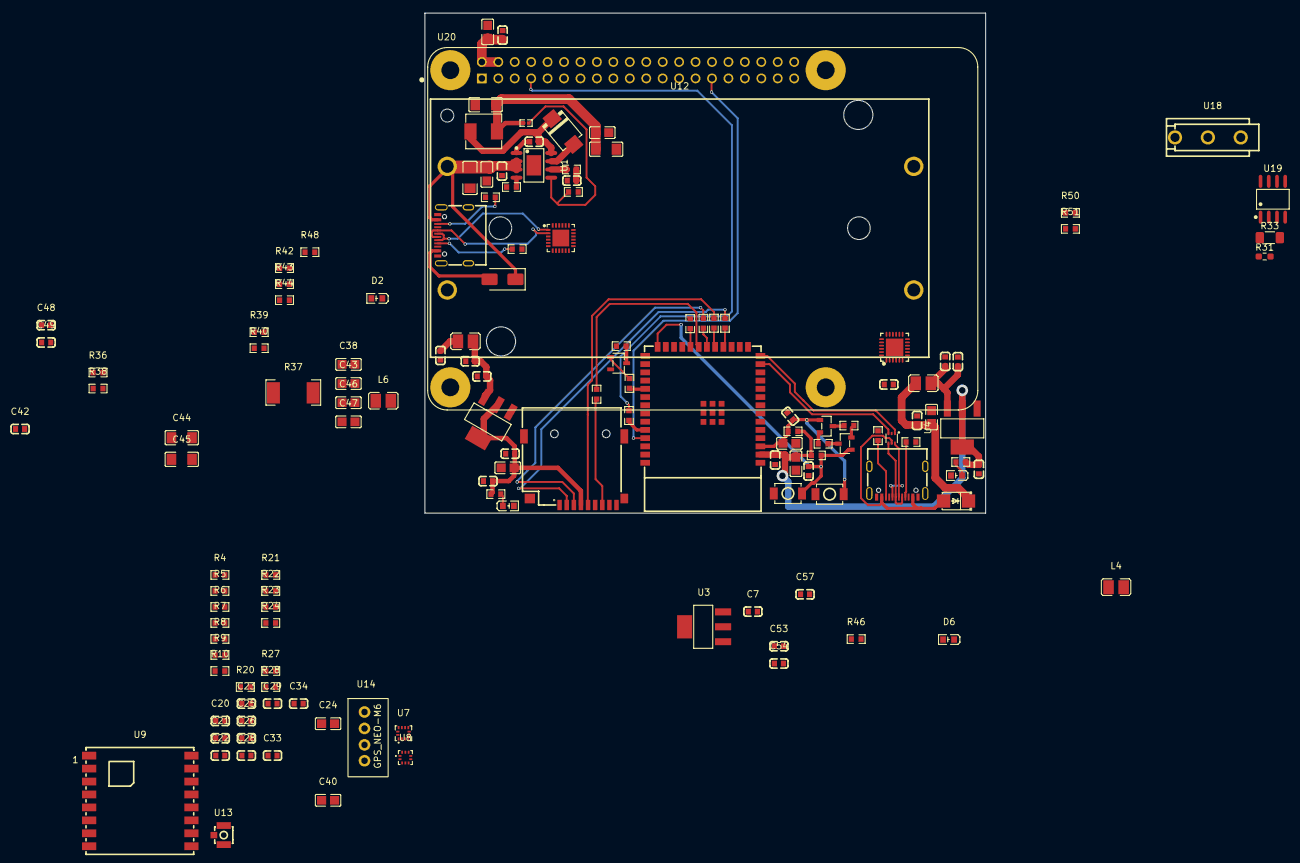
[picture p7: board Hardware/PCB/EPS&PAY/sources/_restore_backup_2026-10-15T00-06-46-763/… from above]

Board: 2 copper layers, 86.6 x 77.2 mm, 139 parts (0 on the bottom side), 98 nets.
